danielmcmillan/irrigation-system/hardware/README.md

## PCBs

PCBs are designed using KiCad.

"irrigation-controller" contains the KiCad project for the central control board.

"remote-unit" contains the KiCad project for the remote solenoid control board.

### Libraries

Some project-specific symbols and footprints are saved in the lib dir.

This external symbol and footprint is used with name "TPS54331DR": https://octopart.com/tps54331dr-texas+instruments-12190905
