danielmcmillan/irrigation-system/(threads)

Thread 1 (2023-07-01):

Visibility of historical values

danielmcmillan, 2023-07-01:
Would be good to be able to see:

- Remote unit voltage trends over time
- How often a remote unit has connectivity issues

Values should be recorded with low cost and presented either through application UI or Grafana.

Closed 2024-04-02.

Thread 10 (2023-07-01):

Indicate controller unit status with LED

danielmcmillan, 2023-07-01:
For identifying an issue such as no WiFi connection.

danielmcmillan, 2023-12-22:
Done, currently these are the possible status indicated:

D1 | D2 |  
-- | -- | --
Off | Off | No WiFi connection, or no power.
Off | On | Initialisation in progress.
On | Off | WiFi connected, MQTT disconnected.
On | On | WiFi and MQTT connected.

Closed 2023-12-22.

Thread 6 (2023-07-01):

Updated controller unit hardware

danielmcmillan, 2023-07-01:
- Changes from prototype: ESP32 connects directly to RF and RS485
- 5v converter likely unnecessary
- Use 3.3v level version of RS485 transceiver
- Secondary processor mega328p may not be required
- Maybe want extra indicator LED(s)

danielmcmillan, 2023-11-25:
Issue for RF module: EN is pulled high instead of low. Must desolder R5 between EN and 3v3, and attaching a wire between EN and GND.
LEDs and relay are working.
Looking into modbus failing (16991)

danielmcmillan, 2023-11-25:
Raised #25 for Modbus communication issues

Closed 2023-11-25.

Thread 22 (2023-07-02):

Handle timing out remote unit better

danielmcmillan, 2023-07-02:
If a solenoid is opened, then communication with the remote unit stops working, then the state of the solenoid gets stuck in open state even though the remote unit itself would shut the valve after some timeout.

Thread 23 (2023-07-23):

Updated remote unit hardware

danielmcmillan, 2023-07-23:
- Update design with fixed solar charging circuit

danielmcmillan, 2023-07-30:
Schematic, parts, and footprints updated. Pending update of PCB design until other changes are confirmed.

danielmcmillan, 2023-07-30:
Note power inductor C253606 has low quantity available, probably can swap with C96164, C357084, C281325, C206300

danielmcmillan, 2023-11-19:
Updated design tested and working

Closed 2023-11-19.

Thread 29 (2023-12-22):

Controller unit multitasking

danielmcmillan, 2023-12-22:
Currently there are periods of unresponsiveness during long running tasks like communication with remote units. This also interrupts processes such as maintaining MQTT connection.

Using FreeRTOS tasks, some processes could run concurrently.

May need to add synchronisation logic to make these thread safe:
* event buffer
* MQTT client (probably need to serialise publish and MQTT client loop)

These things may want to be separate tasks
* sending events from buffer on MQTT
* controller update loop (without locking during long-running process like RF communication)
* Maintaining WiFi and MQTT connection

danielmcmillan, 2024-01-23:
A simpler approach that is less likely to introduce concurrency issues would be to offload only the serial communication to a separate task, and have the controller update loop poll for results in each loop.

Thread 32 (2024-01-06):

Proper handling of remote unit error responses

danielmcmillan, 2024-01-06:
Include some detail about the error in the response.
Handle response for invalid packets (currently command in response is 0xff).

Thread 35 (2024-01-20):

Remote unit voltage converter issue with COMP capacitor

danielmcmillan, 2024-01-20:
The Ccomp/C15 capacitor has capacitance within spec according to the TI Power Designer but unless this capacitor is removed then there are reliability issues when load changes.

Thread 36 (2024-01-20):

Detect disconnected solenoid

danielmcmillan, 2024-01-20:
It may potentially be possible to detect an open circuit on the solenoid connection by looking for an expected drop in voltage after activating the solenoid.

Thread 37 (2024-01-20):

Read sensor value asynchronously

danielmcmillan, 2024-01-20:
Remote unit should read from a sensor in a separate process from the command handling. A command would read the latest value.

This avoids slow command handling when reading the value. It also avoids reading the sensor while RF module is powered on which may cause issues.

danielmcmillan, 2024-01-21:
Added to remote unit revision 8. It is a breaking change change for the get sensor value (0x18) remote unit command.

Closed 2024-01-22.

Thread 41 (2024-04-02):

Remove controller unit property detail messages

danielmcmillan, 2024-04-02:
Instead, on startup/reset, send an update event for anything that is immediately available (e.g. motor is off) and ensure events are sent when first value for a property is received (even if it matches default value, e.g. if remote units are not available)
