danielmcmillan/irrigation-system/hardware/remote-unit/remote-unit.kicad_pcb

## KiCad design hardware/remote-unit/remote-unit.kicad_pcb (2025-11-11)

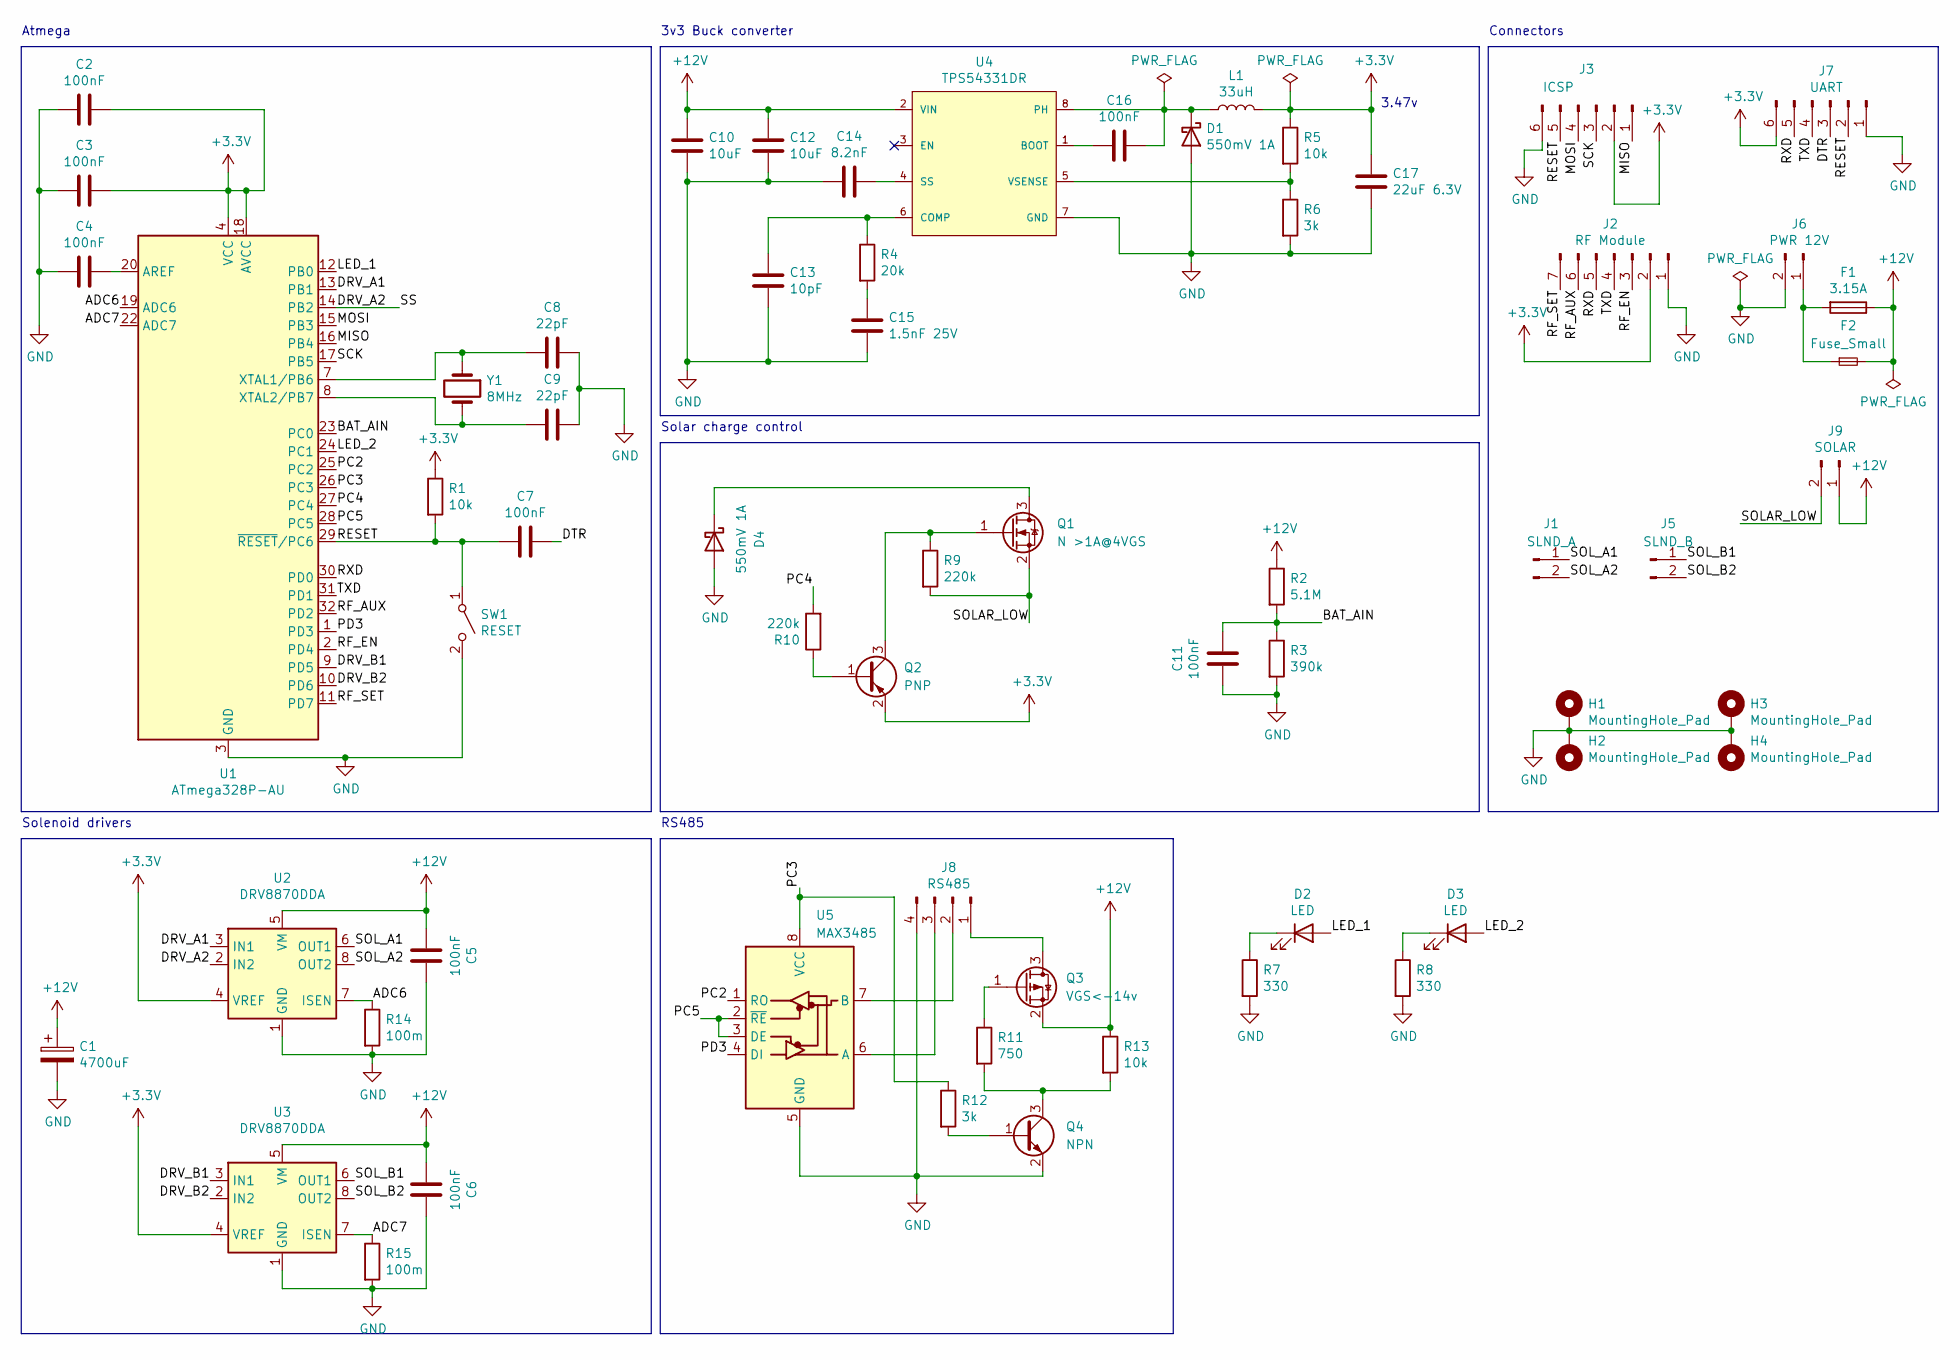
[picture p1: schematic remote-unit.kicad_sch, Irrigation Remote Unit]

Parts:
C1: 4700uF; CP_Radial_D16.0mm_P7.50mm
C2, C3, C4, C5, C6, C7, C11, C16: 100nF; C_0603_1608Metric; JLCPCB Part C14663
C8, C9: 22pF; C_0402_1005Metric; JLCPCB Part C1555
C10, C12: 10uF; C_1206_3216Metric; JLCPCB Part C13585
C13: 10pF; C_0603_1608Metric; JLCPCB Part C1634
C14: 8.2nF; C_0603_1608Metric; JLCPCB Part C1322360
C15: 1.5nF 25V; C_0603_1608Metric; JLCPCB Part C1595
C17: 22uF 6.3V; C_0603_1608Metric; JLCPCB Part C59461
D1, D4: 550mV 1A; D_SMA; JLCPCB Part C2480
D2, D3: LED; LED_0603_1608Metric; JLCPCB Part C2286
F1: 3.15A; L_Radial_D8.7mm_P5.00mm_Fastron_07HCP
F2: Fuse_Small; Fuse_0603_1608Metric; JLCPCB Part C163117
H1, H2, H3, H4: MountingHole_Pad; MountingHole_3mm_Pad
J1: SLND_A; JST_XH_B2B-XH-A_1x02_P2.50mm_Vertical
J2: RF Module; YL_800T
J3: ICSP; PinHeader_2x03_P2.54mm_Vertical
J5: SLND_B; JST_XH_B2B-XH-A_1x02_P2.50mm_Vertical
J6: PWR 12V; JST_XH_B2B-XH-A_1x02_P2.50mm_Vertical
J7: UART; PinHeader_2x03_P2.54mm_Vertical
J8: RS485; JST_XH_B4B-XH-A_1x04_P2.50mm_Vertical
J9: SOLAR; JST_XH_B2B-XH-A_1x02_P2.50mm_Vertical
L1: 33uH; L_8x8mm_H4mm; JLCPCB Part C497847
Q1: N >1A@4VGS; SOT-23; JLCPCB Part C20917
Q2: PNP; SOT-23; JLCPCB Part C8542
Q3: VGS<-14v; SOT-23; JLCPCB Part C8492
Q4: NPN; SOT-23; JLCPCB Part C2150
R1, R5, R13: 10k; R_0402_1005Metric; JLCPCB Part C25744
R2: 5.1M; R_0603_1608Metric; JLCPCB Part C13320
R3: 390k; R_0603_1608Metric; JLCPCB Part C23150
R4: 20k; R_0402_1005Metric; JLCPCB Part C25765
R6, R12: 3k; R_0603_1608Metric; JLCPCB Part C4211
R7, R8: 330; R_0402_1005Metric; JLCPCB Part C25104
R9, R10: 220k; R_0603_1608Metric; JLCPCB Part C22961
R11: 750; R_0603_1608Metric; JLCPCB Part C23241
R14, R15: 100m; R_2512_6332Metric; JLCPCB Part C419755
SW1: RESET; SW_SPST_THT_5.0mm
U1: ATmega328P-AU; TQFP-32_7x7mm_P0.8mm; JLCPCB Part C14877
U2, U3: DRV8870DDA; Texas_HTSOP-8-1EP_3.9x4.9mm_P1.27mm_EP2.95x4.9mm_Mask2.4x3.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; JLCPCB Part C86590
U4: TPS54331DR; Texas_Instruments-TPS54331DR-Level_A; JLCPCB Part C9865
U5: MAX3485; MSOP-8_3x3mm_P0.65mm; JLCPCB Part C5310819
Y1: 8MHz; Crystal_SMD_5032-2Pin_5.0x3.2mm; JLCPCB Part C115962

Connections:
+3.3V: C2.1, C3.1, C17.1, J2.2, J3.2, J7.6, L1.2, Q2.2 (E), R1.1, R5.1, U1.4 (VCC), U1.6 (VCC), U1.18 (AVCC), U2.4 (VREF), U3.4 (VREF)
+12V: C1.1, C5.2, C6.2, C10.1, C12.1, F1.1, F2.2, J9.1, Q3.2 (S), R2.1, R13.1, U2.5 (VM), U3.5 (VM), U4.2 (VIN)
/ADC6: R14.1, U1.19 (ADC6), U2.7 (ISEN)
/ADC7: R15.1, U1.22 (ADC7), U3.7 (ISEN)
/BAT_AIN: C11.1, R2.2, R3.1, U1.23 (PC0)
/DRV_A1: U1.13 (PB1), U2.3 (IN1)
/DRV_A2: U1.14 (PB2), U2.2 (IN2)
/DRV_B1: U1.9 (PD5), U3.3 (IN1)
/DRV_B2: U1.10 (PD6), U3.2 (IN2)
/DTR: C7.1, J7.3
/LED_1: D2.2 (A), U1.12 (PB0)
/LED_2: D3.2 (A), U1.24 (PC1)
/MISO: J3.1, U1.16 (PB4)
/MOSI: J3.4, U1.15 (PB3)
/PC2: U1.25 (PC2), U5.1 (RO)
/PC3: R12.1, U1.26 (PC3), U5.8 (VCC)
/PC4: R10.2, U1.27 (PC4)
/PC5: U1.28 (PC5), U5.2 (~RE), U5.3 (DE)
/PD3: U1.1 (PD3), U5.4 (DI)
/RESET: C7.2, J3.5, J7.2, R1.2, SW1.1 (A), U1.29 (~RESET/PC6)
/RF_AUX: J2.6, U1.32 (PD2)
/RF_EN: J2.3, U1.2 (PD4)
/RF_SET: J2.7, U1.11 (PD7)
/RXD: J2.5, J7.5, U1.30 (PD0)
/SCK: J3.3, U1.17 (PB5)
/SOLAR_LOW: J9.2, Q1.2 (S), R9.2
/SOL_A1: J1.1, U2.6 (OUT1)
/SOL_A2: J1.2, U2.8 (OUT2)
/SOL_B1: J5.1, U3.6 (OUT1)
/SOL_B2: J5.2, U3.8 (OUT2)
/TXD: J2.4, J7.4, U1.31 (PD1)
GND: C1.2, C2.2, C3.2, C4.2, C5.1, C6.1, C8.1, C9.1, C10.2, C11.2, C12.2, C13.2, C14.2, C15.2, C17.2, D1.2 (A), D4.2 (A), H1.1, H2.1, H3.1, H4.1, J2.1, J3.6, J6.2, J7.1, J8.4, Q4.2 (E), R3.2, R6.2, R7.2, R8.2, R14.2, R15.2, SW1.2 (B), U1.3 (GND), U1.5 (GND), U1.21 (GND), U2.1 (GND), U2.9 (GND), U3.1 (GND), U3.9 (GND), U4.7 (GND), U5.5 (GND)
unnamed: C15.1, R4.2
unnamed: C16.1, D1.1 (K), L1.1, U4.8 (PH)
unnamed: D2.1 (K), R7.1
unnamed: D3.1 (K), R8.1
unnamed: D4.1 (K), Q1.3 (D)
unnamed: F1.2, F2.1, J6.1
unnamed: J8.1, Q3.3 (D)
unnamed: J8.2, U5.7 (B)
unnamed: J8.3, U5.6 (A)
unnamed: Q1.1 (G), Q2.3 (C), R9.1
unnamed: Q2.1 (B), R10.1
unnamed: Q3.1 (G), R11.1
unnamed: Q4.1 (B), R12.2
unnamed: Q4.3 (C), R11.2, R13.2
unnamed: C4.1, U1.20 (AREF)
unnamed: C8.2, U1.7 (XTAL1/PB6), Y1.1
unnamed: C9.2, U1.8 (XTAL2/PB7), Y1.2
unnamed: C16.2, U4.1 (BOOT)
unnamed: C13.1, R4.1, U4.6 (COMP)
unnamed: C14.1, U4.4 (SS)
unnamed: R5.2, R6.1, U4.5 (VSENSE)

Notes on the sheet:
Atmega
3v3 Buck converter
Solenoid drivers
Solar charge control
RS485
3.47v
Connectors

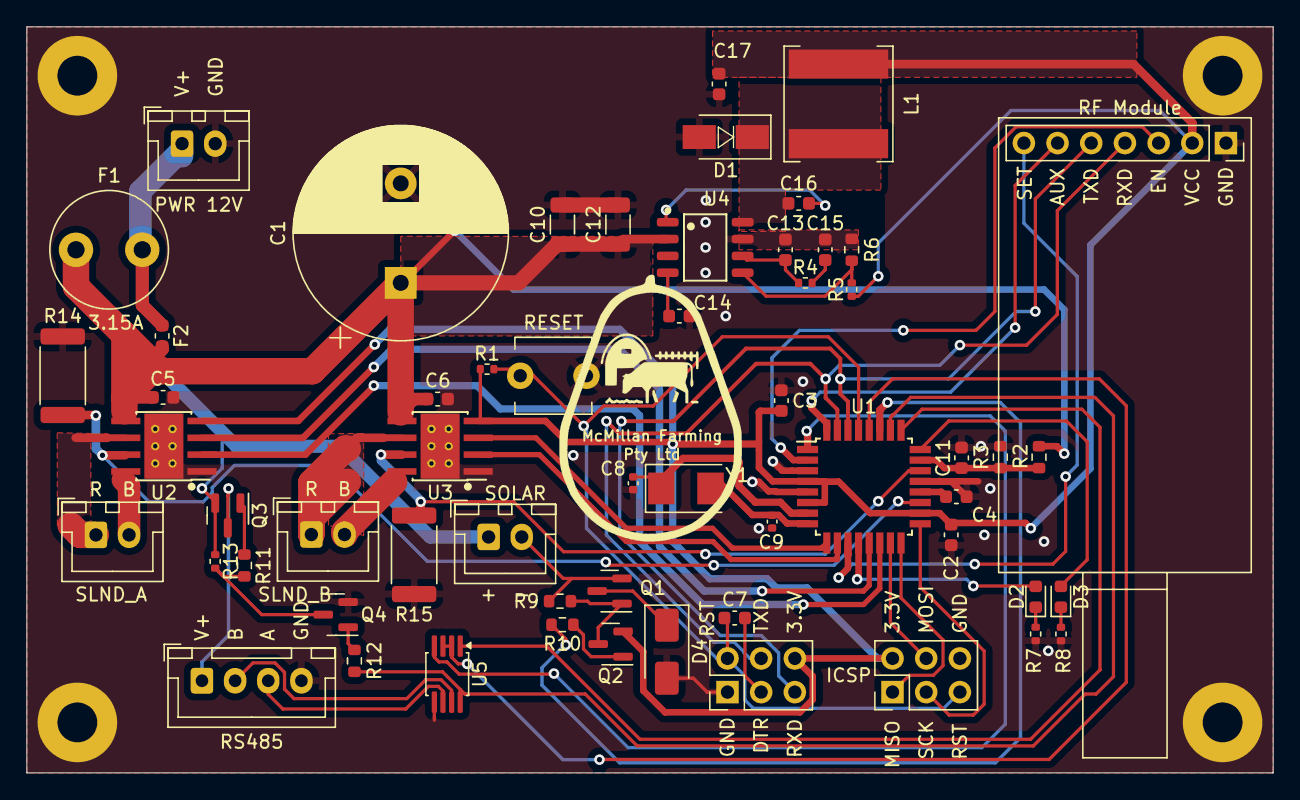
[picture p2: board remote-unit.kicad_pcb from above]

Board: 2 copper layers, 94.0 x 56.3 mm, 62 parts (0 on the bottom side), 53 nets.
