danielmcmillan/irrigation-system/hardware/irrigation-controller/irrigation-controller.kicad_pcb

## KiCad design hardware/irrigation-controller/irrigation-controller.kicad_pcb (2023-11-25)

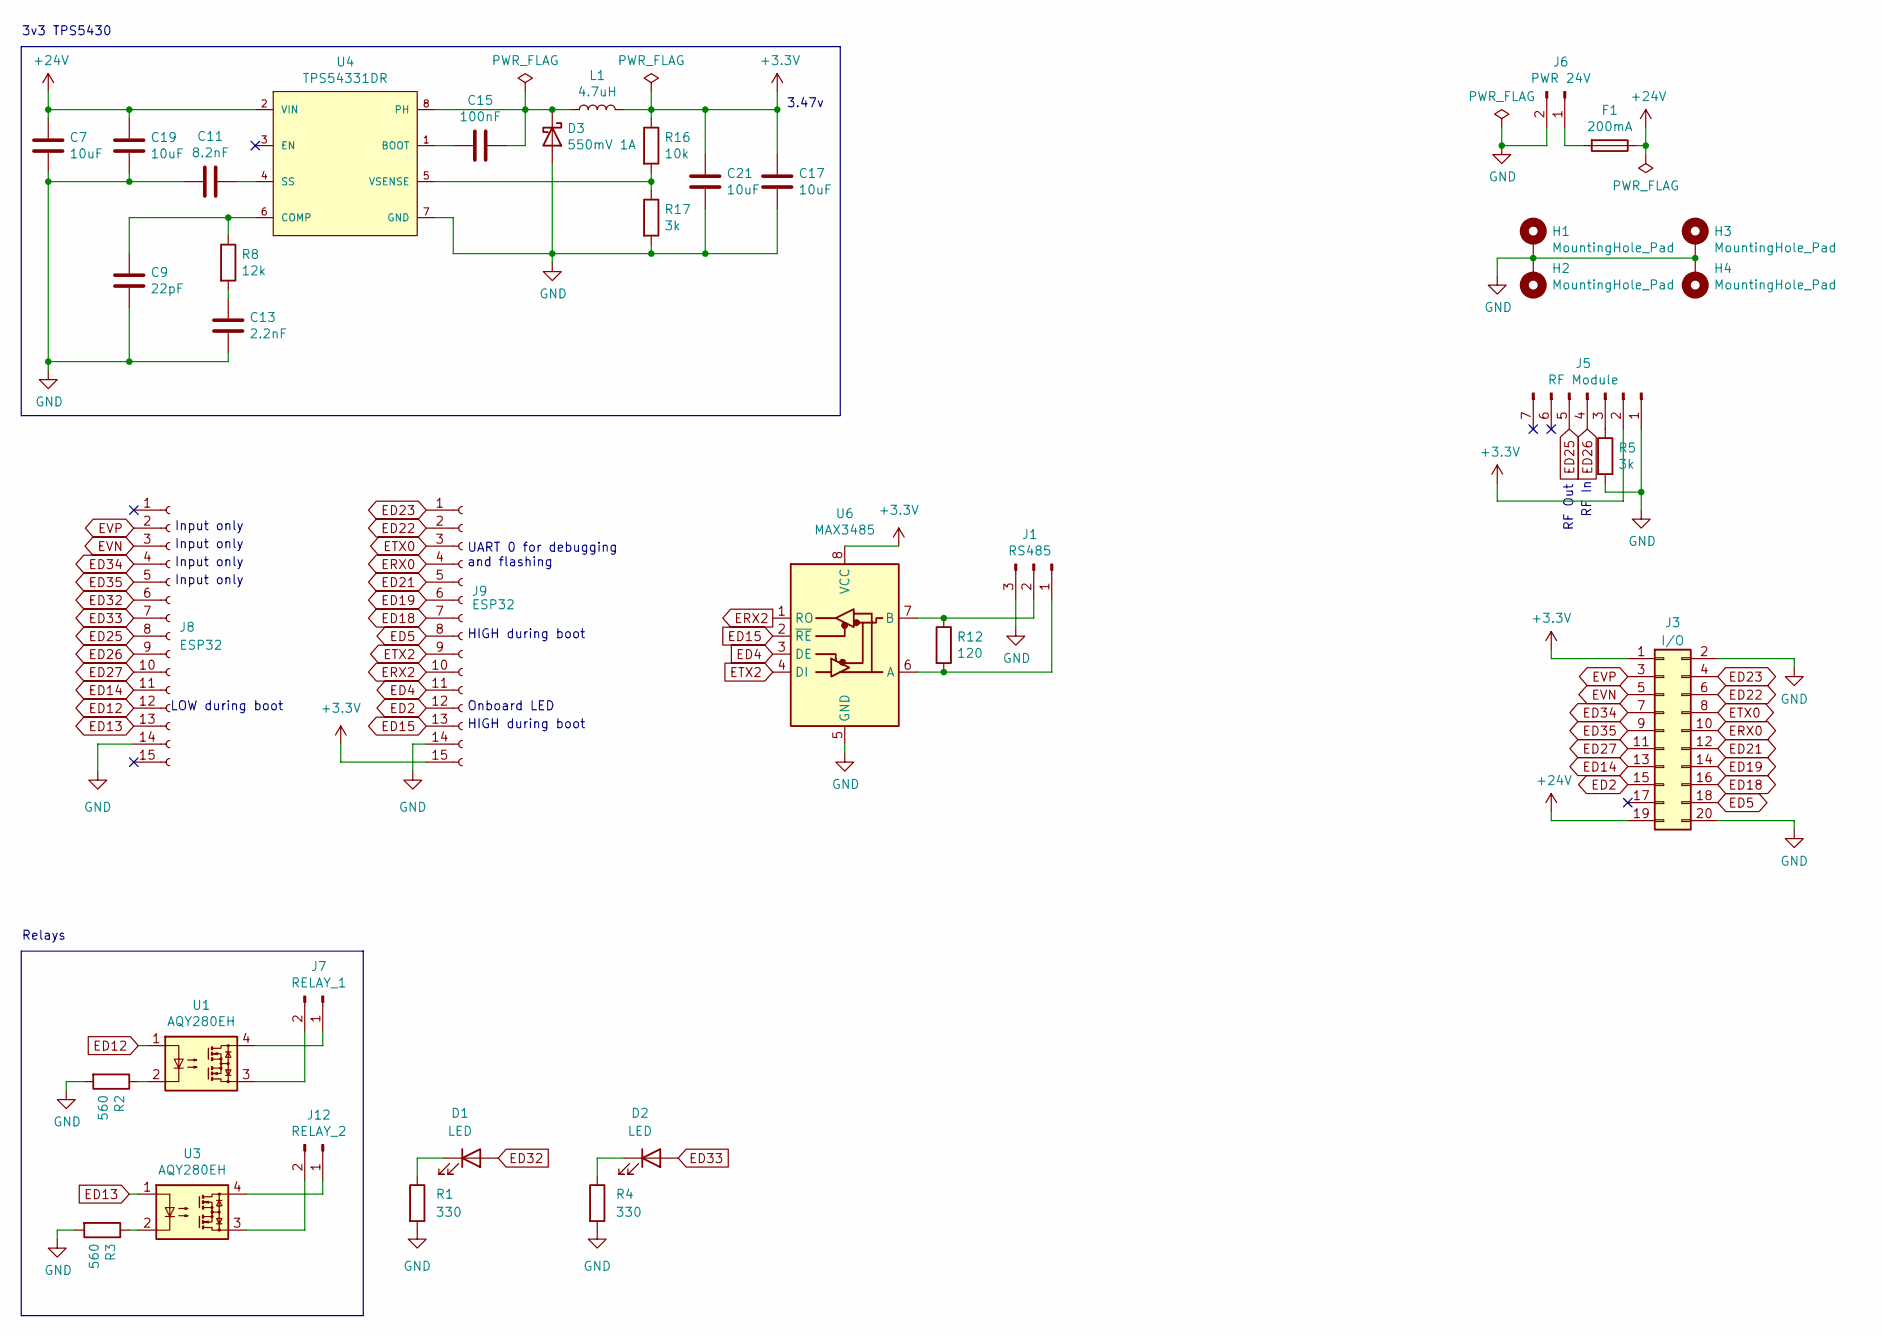
[picture p3: schematic irrigation-controller.kicad_sch, Irrigation Controller Unit]

Parts:
C7, C17, C19, C21: 10uF; C_1206_3216Metric; JLCPCB Part C13585
C9: 22pF; C_0603_1608Metric; JLCPCB Part C1653
C11: 8.2nF; C_0603_1608Metric; JLCPCB Part C1322360
C13: 2.2nF; C_0603_1608Metric; JLCPCB Part C1604
C15: 100nF; C_0603_1608Metric; JLCPCB Part C14663
D1, D2: LED; LED_0603_1608Metric; JLCPCB Part C2286
D3: 550mV 1A; D_SMA; JLCPCB Part C2480
F1: 200mA; L_Radial_D8.7mm_P5.00mm_Fastron_07HCP
H1, H2, H3, H4: MountingHole_Pad; MountingHole_3mm_Pad
J1: RS485; JST_XH_B3B-XH-A_1x03_P2.50mm_Vertical
J3: I/O; PinHeader_2x10_P2.54mm_Vertical
J5: RF Module; YL_800T
J6: PWR 24V; JST_XH_B2B-XH-A_1x02_P2.50mm_Vertical
J7: RELAY_1; JST_XH_B2B-XH-A_1x02_P2.50mm_Vertical
J8, J9: ESP32; PinSocket_1x15_P2.54mm_Vertical
J12: RELAY_2; JST_XH_B2B-XH-A_1x02_P2.50mm_Vertical
L1: 4.7uH; L_Changjiang_FNR4020S; JLCPCB Part C167828
R1, R4: 330; R_0402_1005Metric; JLCPCB Part C25104
R2, R3: 560; R_0603_1608Metric; JLCPCB Part C23204
R5, R17: 3k; R_0603_1608Metric; JLCPCB Part C4211
R8: 12k; R_0603_1608Metric; JLCPCB Part C22790
R12: 120; R_0603_1608Metric; JLCPCB Part C22787
R16: 10k; R_0402_1005Metric; JLCPCB Part C25744
U1, U3: AQY280EH; DIP-4_W7.62mm
U4: TPS54331DR; Texas_Instruments-TPS54331DR-Level_A; JLCPCB Part C9865
U6: MAX3485; DIP-8_W7.62mm

Connections:
+3.3V: C17.1, C21.1, J3.1, J5.2, J9.15, L1.2, R16.1, U6.8 (VCC)
+24V: C7.1, C19.1, F1.1, J3.19, U4.2 (VIN)
ED2: J3.15, J9.12
ED4: J9.11, U6.3 (DE)
ED5: J3.18, J9.8
ED12: J8.12, U1.1
ED13: J8.13, U3.1
ED14: J3.13, J8.11
ED15: J9.13, U6.2 (~RE)
ED18: J3.16, J9.7
ED19: J3.14, J9.6
ED21: J3.12, J9.5
ED22: J3.6, J9.2
ED23: J3.4, J9.1
ED25: J5.5, J8.8
ED26: J5.4, J8.9
ED27: J3.11, J8.10
ED32: D1.2 (A), J8.6
ED33: D2.2 (A), J8.7
ED34: J3.7, J8.4
ED35: J3.9, J8.5
ERX0: J3.10, J9.4
ERX2: J9.10, U6.1 (RO)
ETX0: J3.8, J9.3
ETX2: J9.9, U6.4 (DI)
EVN: J3.5, J8.3
EVP: J3.3, J8.2
GND: C7.2, C9.2, C11.2, C13.2, C17.2, C19.2, C21.2, D3.2 (A), H1.1, H2.1, H3.1, H4.1, J1.3, J3.2, J3.20, J5.1, J6.2, J8.14, J9.14, R1.2, R2.2, R3.2, R4.2, R5.2, R17.2, U4.7 (GND), U6.5 (GND)
unnamed: C13.1, R8.2
unnamed: D1.1 (K), R1.1
unnamed: D2.1 (K), R4.1
unnamed: C15.1, D3.1 (K), L1.1, U4.8 (PH)
unnamed: J1.1, R12.2, U6.6 (A)
unnamed: J1.2, R12.1, U6.7 (B)
unnamed: J5.3, R5.1
unnamed: F1.2, J6.1
unnamed: J7.1, U1.4
unnamed: J7.2, U1.3
unnamed: J12.1, U3.4
unnamed: J12.2, U3.3
unnamed: R2.1, U1.2
unnamed: R3.1, U3.2
unnamed: C15.2, U4.1 (BOOT)
unnamed: C9.1, R8.1, U4.6 (COMP)
unnamed: C11.1, U4.4 (SS)
unnamed: R16.2, R17.1, U4.5 (VSENSE)

Notes on the sheet:
RF Out
RF In
Input only
Onboard LED
HIGH during boot
LOW during boot
UART 0 for debugging and flashing
3.47v
Relays
3v3 TPS5430

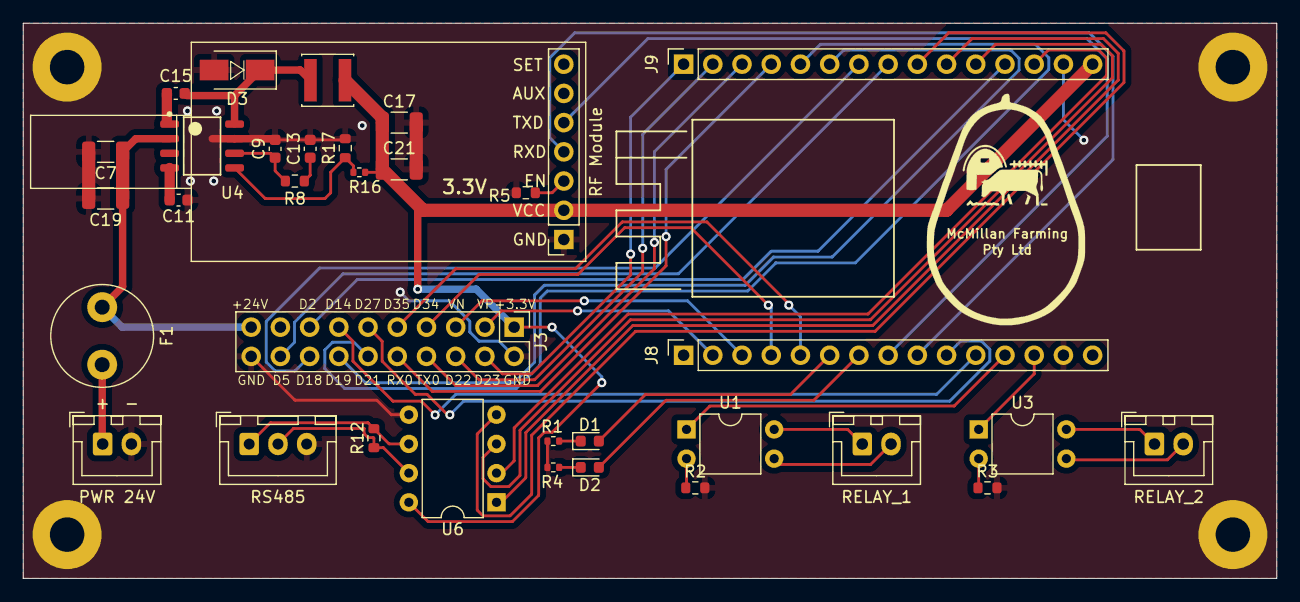
[picture p4: board irrigation-controller.kicad_pcb from above]

Board: 2 copper layers, 109.0 x 48.3 mm, 38 parts (0 on the bottom side), 46 nets.
