danielmcmillan/irrigation-system/software/src/remote-unit/sensor.cpp

#include "sensor.h"
#include <Arduino.h>
#include "crc16.h"

uint8_t rs485ReadWaterPotentialCommand[] = {0x02,
                                            0x03,
                                            0x00,
                                            0x00,
                                            0x00,
                                            0x01,
                                            0x84,
                                            0x39};

RemoteUnitSensor::RemoteUnitSensor(const RemoteUnitConfig &config, uint8_t rxPin, uint8_t txPin, uint8_t reDePin, uint8_t rs485EnablePin)
    : config(config), txPin(txPin), reDePin(reDePin), rs485EnablePin(rs485EnablePin), ss(rxPin, txPin), lastUpdateCounts(0),
      readPending(false), lastResult({0}), sensorValue(0x7fff)
{
}

void RemoteUnitSensor::setup()
{
    rs485Setup();
}

int RemoteUnitSensor::update(unsigned long counts)
{
    uint16_t intervalCounts = (uint16_t)config.getSensorUpdateInterval() * 64;
    if (readPending)
    {
        readPending = false;
        uint8_t error = readValue(0, &sensorValue);
        lastResult.success = error == 0;
        lastResult.unread = true;
        lastResult.error = error;
    }
    else if (lastUpdateCounts == 0xffffffff || (intervalCounts != 0 && (counts - lastUpdateCounts) > intervalCounts))
    {
        lastUpdateCounts = counts;
        readPending = true;
        // Turn sensor on to give it time to power up before next interval
        digitalWrite(rs485EnablePin, HIGH);
    }
    return 0;
}

RemoteUnitSensor::SensorReadingResult RemoteUnitSensor::getValue(uint8_t sensor, uint16_t *valueOut)
{
    *valueOut = sensorValue;
    RemoteUnitSensor::SensorReadingResult result = lastResult;
    lastResult.unread = false;
    return result;
}

void RemoteUnitSensor::scheduleUpdate()
{
    lastUpdateCounts = 0xffffffff;
}

uint8_t RemoteUnitSensor::readValue(uint8_t sensor, uint16_t *valueOut)
{
    uint8_t result = 0;
    // Clear any previous data in Serial buffer
    while (ss.available() > 0)
    {
        ss.read();
    }

    // Start up sensor and RS485 transmitter
    rs485On();
    rs485Mode(true);
    delayMicroseconds(50);

    // Write out command to read water potential value
    ss.write(rs485ReadWaterPotentialCommand, sizeof(rs485ReadWaterPotentialCommand));
    ss.flush();
    delayMicroseconds(50);

    // Disable RS485 transmitter and enable receive
    rs485Mode(false);
    uint8_t response[7] = {0};
    size_t responseLength = ss.readBytes(response, 7);

    if (responseLength == 7 && response[0] == 2 && response[1] == 3 && response[2] == 2)
    {
        uint16_t crc = IrrigationSystem::CRC::crc16(response, responseLength);
        if (crc == 0)
        {
            result = 0;
            *valueOut = (((uint16_t)response[3]) << 8) + (uint16_t)(response[4]);
        }
        else
        {
            result = 2;
        }
    }
    else
    {
        result = 1;
    }

    rs485Off();
    return result;
}

void RemoteUnitSensor::rs485Setup()
{
    pinMode(rs485EnablePin, OUTPUT);
    rs485Off();
}
void RemoteUnitSensor::rs485Off()
{
    ss.end();
    pinMode(reDePin, INPUT);
    pinMode(txPin, INPUT);
    digitalWrite(rs485EnablePin, LOW);
}
void RemoteUnitSensor::rs485On()
{
    // SoftwareSerial library is setting up the pin only in the constructor
    digitalWrite(txPin, HIGH);
    pinMode(txPin, OUTPUT);
    ss.begin(9600);
    ss.setTimeout(2000);
    digitalWrite(rs485EnablePin, HIGH);
}
void RemoteUnitSensor::rs485Mode(bool tx)
{
    digitalWrite(reDePin, tx ? HIGH : LOW);
    pinMode(reDePin, OUTPUT);
}
