danielmcmillan/irrigation-system/software/src/control-processor/controllers/controller-builder.cpp

#include "controller-builder.h"

namespace IrrigationSystem
{
    ControllerBuilder::ControllerBuilder() : vacon100Controller(0x02),
                                             fertigationController(0x03),
                                             remoteUnitController(0x04),
                                             registeredControllers({{0x02, &this->vacon100Controller},
                                                                    {0x03, &this->fertigationController},
                                                                    {0x04, &this->remoteUnitController}})
    {
    }

    ControllerManager ControllerBuilder::buildManager()
    {
        return ControllerManager(&this->registeredControllers[0], sizeof(this->registeredControllers) / sizeof(this->registeredControllers[0]));
    }
}
