danielmcmillan/irrigation-system/software/src/remote-unit/settings.h

/**
 * Software revision number.
 */
#define REMOTE_UNIT_REVISION 9

/**
 * Whether hardware has solenoid current sense resistors
 */
#define HAS_CURRENT_SENSOR 1

/**
 * Unique 16 bit identifier for a remote unit.
 * Each remote unit should have a unique value.
 */
#define NODE_ID 0x0040
