danielmcmillan/irrigation-system/software/src/control-processor/error-handler.h

#ifndef _CONTROL_I2C_ERROR_HANDLER_H
#define _CONTROL_I2C_ERROR_HANDLER_H
#include <Arduino.h>

enum class ErrorComponent : uint8_t
{
    Wifi,
    Mqtt,
    Config,
    Controller,
    Update
};

typedef std::function<bool(const uint8_t *data, size_t size)> PublishErrorData;

class ErrorHandler
{
public:
    ErrorHandler(PublishErrorData publishErrorData);
    void handleError(ErrorComponent component, uint16_t code, const char *text) const;

private:
    PublishErrorData publishErrorData;
    mutable struct
    {
        unsigned long time;
        ErrorComponent component;
        uint16_t code;
    } lastPublishedError;

    bool shouldPublish(ErrorComponent component, uint16_t code) const;
};

#endif
