danielmcmillan/irrigation-system/software/src/control-processor/ArduinoLibModbus/modbus-version.h

/*
 * Copyright © 2010-2014 Stéphane Raimbault <stephane.raimbault@gmail.com>
 *
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
 * You should have received a copy of the GNU Lesser General Public
 * License along with this library; if not, write to the Free Software
 * Foundation, Inc., 51 Franklin Street, Fifth Floor, Boston, MA 02110-1301 USA
 */

#ifndef MODBUS_VERSION_H
#define MODBUS_VERSION_H

/* The major version, (1, if %LIBMODBUS_VERSION is 1.2.3) */
#define LIBMODBUS_VERSION_MAJOR (3)

/* The minor version (2, if %LIBMODBUS_VERSION is 1.2.3) */
#define LIBMODBUS_VERSION_MINOR (1)

/* The micro version (3, if %LIBMODBUS_VERSION is 1.2.3) */
#define LIBMODBUS_VERSION_MICRO (4)

/* The full version, like 1.2.3 */
#define LIBMODBUS_VERSION 3.1.4

/* The full version, in string form (suited for string concatenation)
 */
#define LIBMODBUS_VERSION_STRING "3.1.4"

/* Numerically encoded version, eg. v1.2.3 is 0x010203 */
#define LIBMODBUS_VERSION_HEX ((LIBMODBUS_VERSION_MAJOR << 16) | \
                               (LIBMODBUS_VERSION_MINOR << 8) |  \
                               (LIBMODBUS_VERSION_MICRO << 0))

/* Evaluates to True if the version is greater than @major, @minor and @micro
 */
#define LIBMODBUS_VERSION_CHECK(major, minor, micro) \
    (LIBMODBUS_VERSION_MAJOR > (major) ||            \
     (LIBMODBUS_VERSION_MAJOR == (major) &&          \
      LIBMODBUS_VERSION_MINOR > (minor)) ||          \
     (LIBMODBUS_VERSION_MAJOR == (major) &&          \
      LIBMODBUS_VERSION_MINOR == (minor) &&          \
      LIBMODBUS_VERSION_MICRO >= (micro)))

#endif /* MODBUS_VERSION_H */
