danielmcmillan/irrigation-system/(commit log)

2021-09-07 Add more controller board connectors
    [irrigation-controller.sch]
2021-09-08 Add controller relay 4
    [irrigation-controller.sch]
2021-09-08 Add i2c_2
    [irrigation-controller.sch]
2021-09-08 Add controller PWR input
    [irrigation-controller.sch]
2021-09-09 Add custom library
    [irrigation-controller.kicad_pcb, irrigation-controller.sch]
2021-09-09 Update board settings
    [irrigation-controller.kicad_pcb]
2021-09-09 Fix relay symbol pins
    [irrigation-controller.sch]
2021-09-09 Initial controller pcb footprint import
    [irrigation-controller.kicad_pcb, irrigation-controller.sch]
2021-09-10 Add SW2 and FLOW header
    [irrigation-controller.sch]
2021-09-11 Controller board layout wip
    [irrigation-controller.kicad_pcb, irrigation-controller.sch]
2021-09-12 Controller pcb layout mostly complete
    [irrigation-controller.kicad_pcb, irrigation-controller.sch]
2021-09-12 Route all controller board nets
    [irrigation-controller.kicad_pcb, irrigation-controller.sch]
2021-09-12 Controller pcb silkscreen fixup
    [irrigation-controller.kicad_pcb]
2021-09-12 Increase clearance for controller board
    [irrigation-controller.kicad_pcb]
2021-09-12 Add controller board author name
    [irrigation-controller.kicad_pcb]
2021-09-12 Add avocado image to controller board
    [irrigation-controller.kicad_pcb]
2021-09-12 Fix missing smd flags
    [irrigation-controller.kicad_pcb]
2021-09-14 Controller board cosmetic changes
    [irrigation-controller.kicad_pcb]
2021-09-18 Add remote unit board
    [irrigation-controller.kicad_pcb, remote-unit.kicad_pcb, remote-unit.sch]
2021-09-18 Add dot marker on motor drivers
    [remote-unit.kicad_pcb]
2021-10-17 Update inductor footprint on remote unit
    [remote-unit.kicad_pcb, remote-unit.sch]
2021-10-18 Add boost converter for solar panel
    [remote-unit.kicad_pcb, remote-unit.sch]
2021-10-29 Fix remote unit buck converter
    Compensation capacitor value was wrong.
    Move output capacitor closer.
    [remote-unit.kicad_pcb, remote-unit.sch]
2021-11-13 Initial prototype of controller and remote unit
2021-11-16 Prototype I2C communication with crc
2021-12-30 More i2c communication testing
2021-12-31 Add library for controlling motor driver over Modbus
2022-01-03 Initial i2c interface for controller
2022-01-05 Track availability of vacon controller
2022-04-29 Add class for solenoid control
2022-04-29 Handle remote unit solenoid commands
2022-04-29 Handle remote unit battery commands
2022-04-29 Apply configured remote unit solenoid timeout
2022-04-29 Fix remote unit issues
    [main.cpp, rf-module.cpp, rf-module.h, solenoids.cpp]
2022-04-29 Fix remote unit cli serial timeout
    [serial.h]
2022-04-29 Support forcing remote unit solenoid activation
2022-04-30 Remote unit update LED indicators
2022-04-30 Remote unit sleep when maintaining battery and add get timer command
2022-04-30 Handle packet build error in remote unit cli
    [main.cpp]
2022-05-01 Mathematical round of remote unit voltage reading
2022-05-01 Fix apply RF config command not sending response
    [command-handler.cpp]
2022-05-01 Fix remote unit config EEPROM CRC
    [config.cpp, settings.h]
2022-05-01 Fix remote unit fail to configure RF module on powerup
    [config.cpp, rf-module.cpp, settings.h]
2022-09-25 Add control processor i2c packet handling
2022-11-19 Fix Vacon modbus addresses
    [vacon-100-modbus-client.cpp]
2022-12-30 Fix i2c property set command
2022-12-31 Add response size to I2C responses
2023-01-01 Fix vacon property ids
    [controller-builder.cpp, controller-builder.h, main.cpp]
2023-01-02 Raise events for Vacon communication errors
    [vacon-100-controller.cpp, vacon-100-controller.h, vacon-100-modbus-client.cpp, vacon-100-modbus-client.h]
2023-01-02 Add I2C command for reading events
2023-01-03 Fix error when missing event handler
    [vacon-100-controller.cpp]
2023-01-03 Cut down TwoWire library to save memory
2023-01-03 Fix incorrect values read from Modbus
    [vacon-100-modbus-client.cpp]
2023-01-03 Avoid some strings being stored in SRAM
    Remove call to modbus_strerror
    Move some log strings to flash
    [vacon-100-modbus-client.cpp]
2023-01-04 Cut down libmodbus library to save memory
2023-01-04 Fix rs485 begin not called
    [modbus-rtu.cpp]
2023-01-04 Add device parameter to vacon simulator
2023-01-04 Replace event timestamp with sequential id
    [i2c-interface.cpp, main.cpp]
2023-02-19 Add error threshold before Vacon 100 is considered unavailable
    [vacon-100-controller.cpp, vacon-100-controller.h]
2023-02-26 Improve remote unit error handling
    [remote-unit-controller.cpp, remote-unit-controller.h]
2023-03-19 Add net host error handler
    [config.cpp, config.h, error-handler.cpp, error-handler.h, main.cpp, mqtt-client.cpp, mqtt-client.h]
2023-03-19 Restart ESP after connection failures
    [main.cpp]
2023-03-26 Add clear log button
2023-03-29 Fix modbus write response handling
    [modbus.c, override-headers.h, vacon-100-controller.cpp]
2023-04-01 Config UI stepper fields
2023-04-05 Throttle repetitive publishing of errors
    [error-handler.cpp, error-handler.h]
2023-04-05 UI mqtt device id configured in environment
2023-04-07 Fix subscribing to all devices
2023-04-07 Fix feedback pressure unit
2023-04-07 Add i2c get state command
2023-04-07 Auto reset and configure control processor
    [config.cpp, main.cpp, mqtt-client.cpp, mqtt-client.h]
2023-06-24 Control vacon via relay
2023-07-01 Fix other controller event history buffer overflow
    [main.cpp]
2023-07-22 Store device state in dynamodb
2023-07-30 Update remote unit schematic
    Kicad 7 upgrade.
    Updated solar charging components.
    Updated JLCPCB component ids based on availability.
    [remote-unit.kicad_sch]
2023-07-30 Add connected and config to device state
2023-08-27 Track historical device connected state
2023-10-02 Add remote unit RS485 moisture sensor support
2023-10-02 Read sensor value from configured remote units
2023-10-03 Fix iteration of remote unit properties
    [main.cpp]
2023-10-28 Irrigation controller Kicad 7 schematic
    [irrigation-controller.kicad_sch]
2023-10-29 Update irrigation controller board
    Remove atmega328p
    Remove 5v voltage regulator
    Replace max485 with max3485
    Remove signal relays
    Add female headers for ESP32
    Add two LEDs
    Update BOM based on JLCPCB availability
    [irrigation-controller.kicad_pcb, irrigation-controller.kicad_sch, remote-unit.kicad_sch]
2023-11-20 Support configuration of rs485 sensor power-on delay
2023-11-25 Add RS485 to remote unit schematic
    [remote-unit.kicad_sch]
2023-11-25 Update remote unit PCB
    [irrigation-controller.kicad_pcb, remote-unit.kicad_pcb, remote-unit.kicad_sch]
2023-11-25 Fix for controller RF EN pin
    [irrigation-controller.kicad_pcb, irrigation-controller.kicad_sch]
2023-11-25 Fix controller Vacon relay pin
    [vacon-100-controller.cpp]
2023-11-25 Fix modbus error code getting truncated
    [vacon-100-modbus-client.cpp]
2023-12-20 Increase timeout when reading sensor
2023-12-20 Add motor modbusEnabled to ui config
2023-12-20 Sensor value conversion for old UI
2023-12-21 Fix crash caused by invalid mqtt topic
    [main.cpp, mqtt-client.cpp, remote-unit-controller.cpp]
2024-01-14 Encode sensor reading errors in result
    [command-handler.h, sensor.cpp]
2024-01-14 Skip RF init when there are no remote units
    [main.cpp, remote-unit-controller.cpp]
2024-01-21 Remote unit LED flashing on startup
2024-01-22 Remote unit automatic scheduling for sensor reading
2024-01-22 Update remote unit controller sensor value handling
2024-01-23 Publish with QoS 1 to avoid missed events
    [main.cpp, mqtt-client.cpp]
2024-01-25 Fix sending two started events on first control unit startup
    [controllers.cpp, main.cpp]
2024-01-26 Renaming for device message types
2024-01-27 Support retrieving device state updates on websocket
2024-01-27 Temporarily restore sensor conversion in ui
2024-01-31 Update sensor conversion in old ui
2024-02-03 Fix remote unit charge control FET pin mismatch
    [remote-unit.kicad_pcb, remote-unit.kicad_sch]
2024-03-31 Add ui2 logout button
2024-04-01 Hide empty mositure sensor value in ui
2024-04-01 Add read sensor to remote unit tool
2024-04-01 Fix ui property filter
2024-04-01 Add zones to sensor component name
2024-04-01 Support setting ui device id
2024-04-02 Lambda logs parsed device messages
2024-04-02 Avoid recording unknown/empty property values
    [controllers.cpp, main.cpp, remote-unit-controller.cpp, remote-unit-controller.h, vacon-100-controller.cpp, vacon-100-controller.h]
2024-04-05 Add fertigation flow rate sensor
2024-08-11 Add device schedule to API
2024-08-11 Minor ui updates
    Upgrade amplify.
    Use button group for properties filter.
2024-08-11 Fix prop name mismatch
2024-11-03 Fix handling of schedule abort
    [serverless.yaml]
2024-11-03 Abort schedule when device restarts
2024-11-03 Filter web push notifications by device id
2024-11-03 Unique ui app title for different stages
2025-11-09 Remote unit Kicad upgrade
    [remote-unit.kicad_pcb, remote-unit.kicad_sch]
2025-11-09 Fix remote unit rs485 sensor power supply circuit
    Replace BJT with mosfet with appropriate source-gate voltage rating
    [remote-unit.kicad_pcb, remote-unit.kicad_sch]
2025-11-09 Update remote unit buck converter
    Update compensation network values.
    Redo layout.
    [remote-unit.kicad_pcb, remote-unit.kicad_sch]
2025-11-09 Update remote unit for jlcpcb fabrication
    [remote-unit.kicad_pcb, remote-unit.kicad_sch]
2025-11-09 Add SMT fuse to remote unit
    [remote-unit.kicad_pcb, remote-unit.kicad_sch]
2025-11-09 Use SMT MAX3485 for remote unit
    [remote-unit.kicad_pcb, remote-unit.kicad_sch]
2025-11-11 Add remote unit current sense resistors
    [remote-unit.kicad_pcb, remote-unit.kicad_sch]
2025-11-30 Remote unit reporting low current fault
2025-11-30 Add friendly text for low current alert in web API
2025-12-20 Push notification for low solenoid current
2026-04-10 Disable remote unit voltage alerts
2026-04-11 Combine saved schedule buttons
2026-04-11 Add quick set buttons for schedule duration
